mlungisimelusi/edge-vehicle-theft-detection/(commit log)

2026-10-11 Beta prototype for IPJ527C
2026-11-03 Final version: AES-128-GCM link security, arm/disarm, speed envelope detector, evaluation and benchmark tools
